d00616/P300/Hardware/Einbau-Sensorboard.jpg

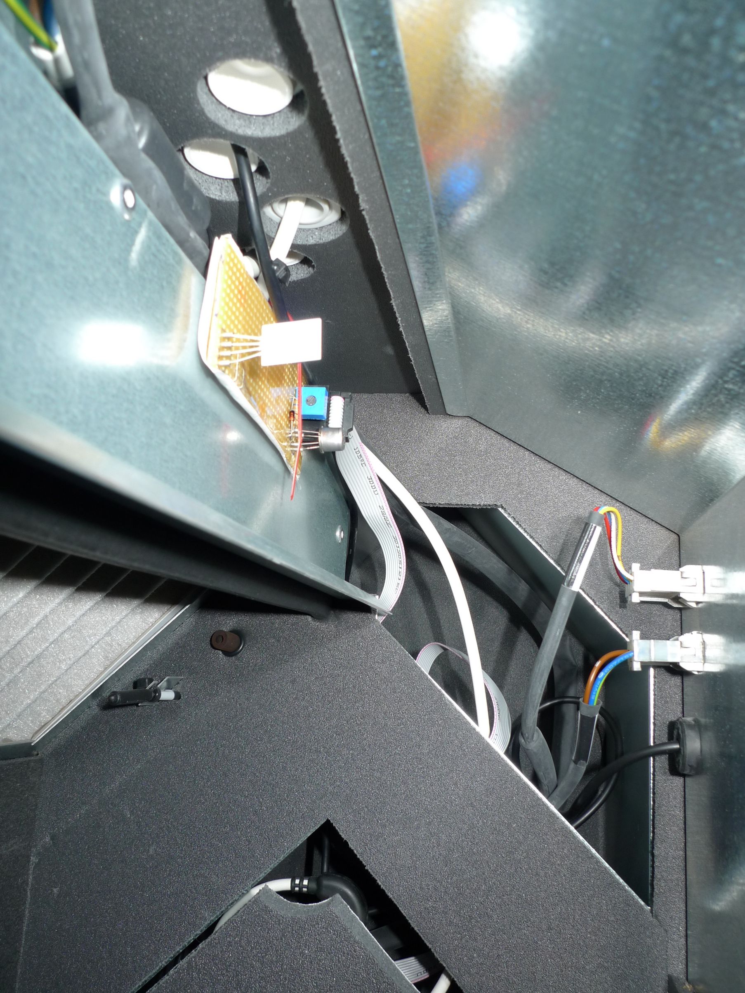
Hardware/Einbau-Sensorboard.jpg
