d00616/P300/Hardware/Einbau-und-Test-12V-Remote-Control.jpg

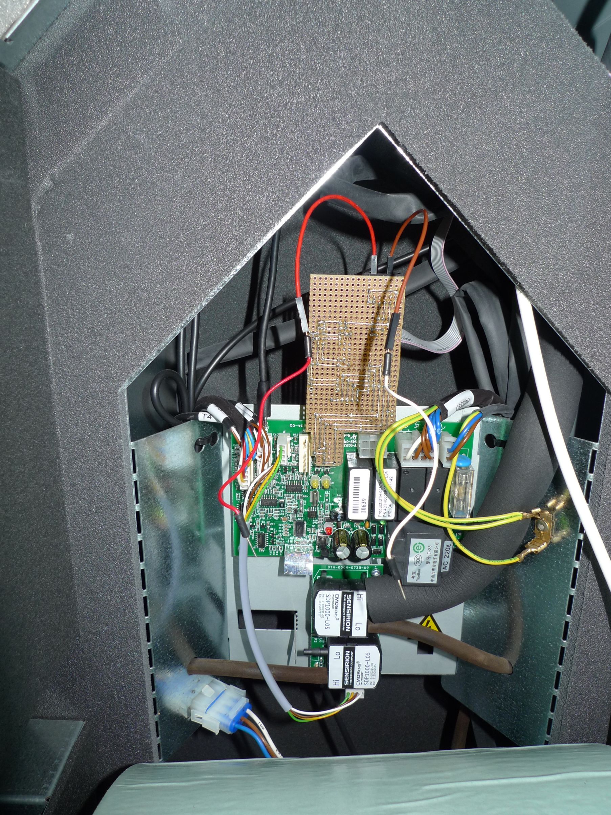
Hardware/Einbau-und-Test-12V-Remote-Control.jpg
