d00616/P300/Hardware/Einbau-Bestueckung.jpg

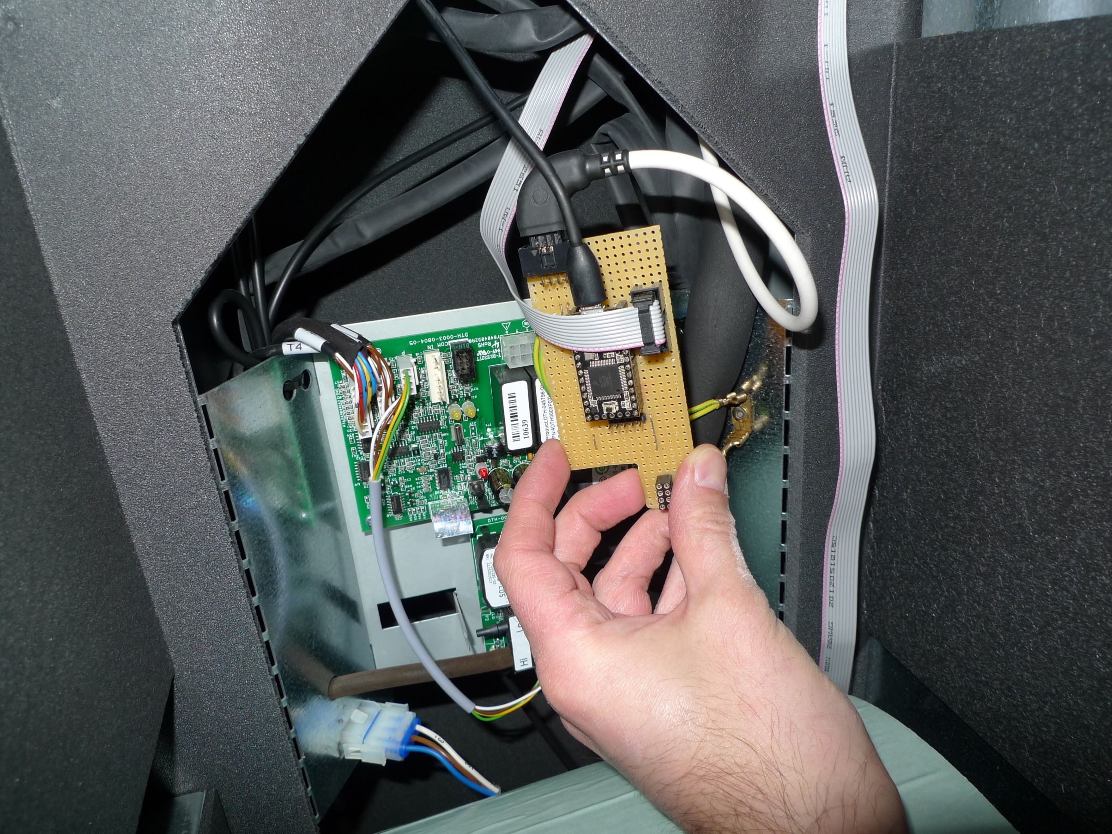
Hardware/Einbau-Bestueckung.jpg
