d00616/P300/Hardware/Einbau-USB-Kabel.jpg

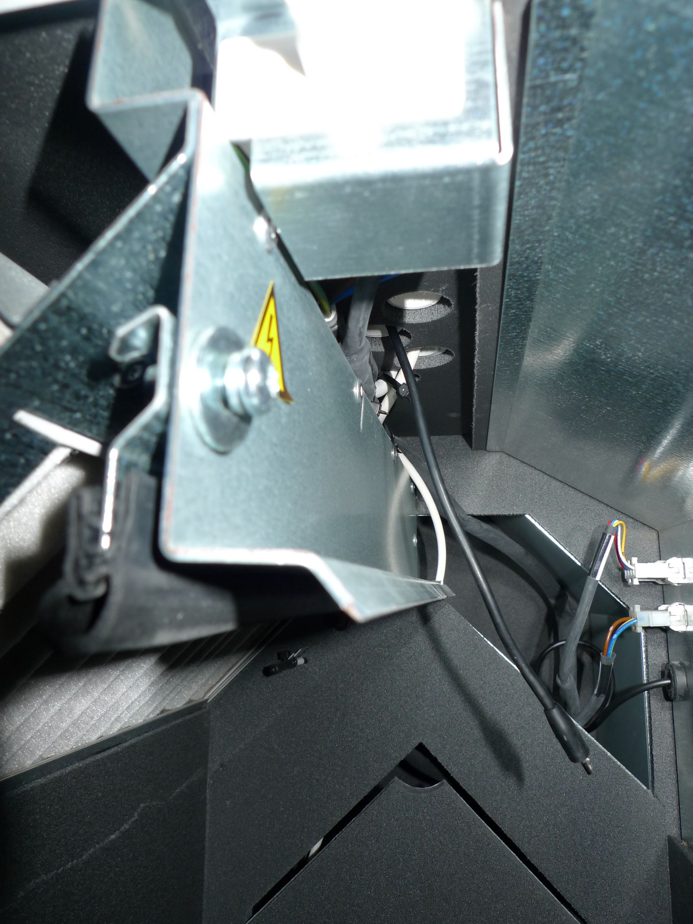
Hardware/Einbau-USB-Kabel.jpg
