d00616/P300/Hardware/Lochraster-Schema.jpg

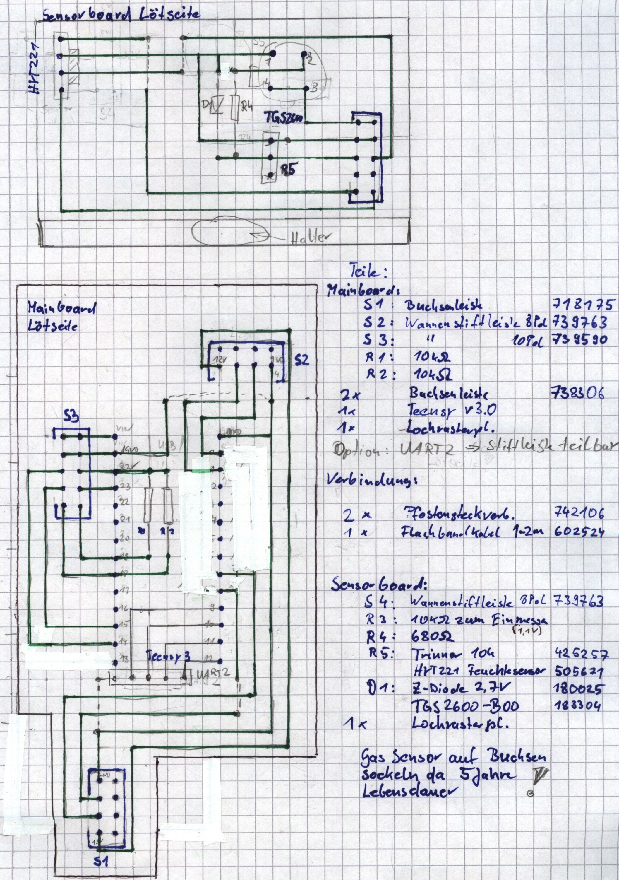
Hardware/Lochraster-Schema.jpg
