d00616/P300/Hardware/mainboard-bestueckt.jpg

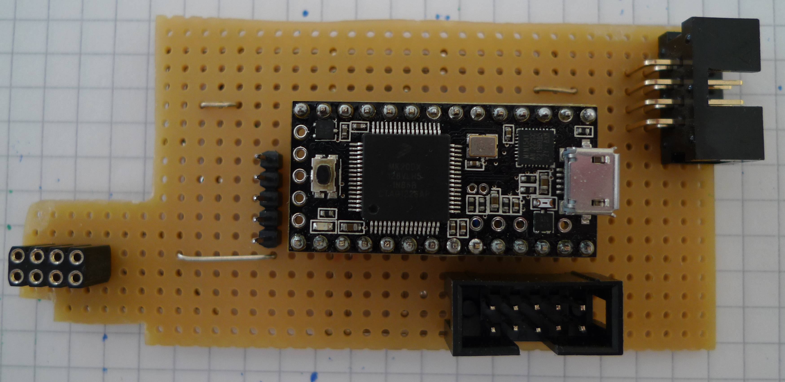
Hardware/mainboard-bestueckt.jpg
