d00616/P300/Hardware/mainboard-oben.jpg

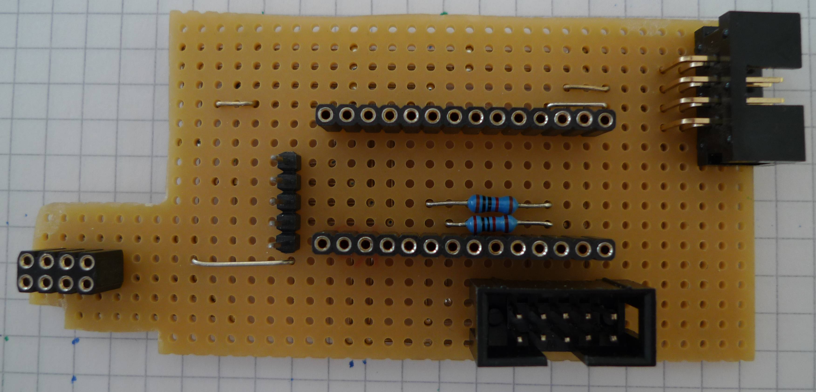
Hardware/mainboard-oben.jpg
