d00616/P300/Hardware/mainboard-unten.jpg

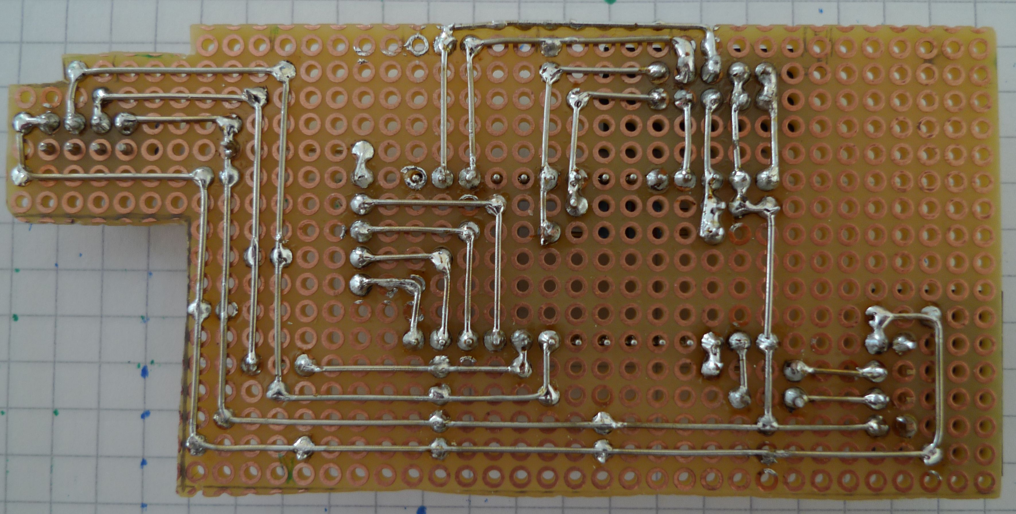
Hardware/mainboard-unten.jpg
