d00616/P300/Hardware/sensor-oben.jpg

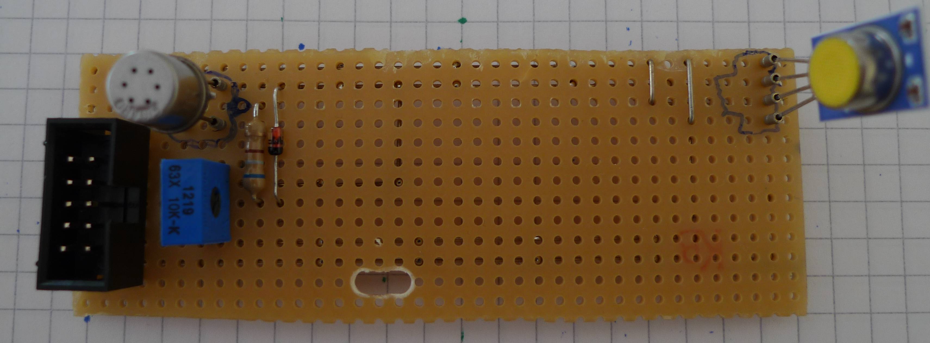
Hardware/sensor-oben.jpg
