d00616/P300/Hardware/sensor-unten.jpg

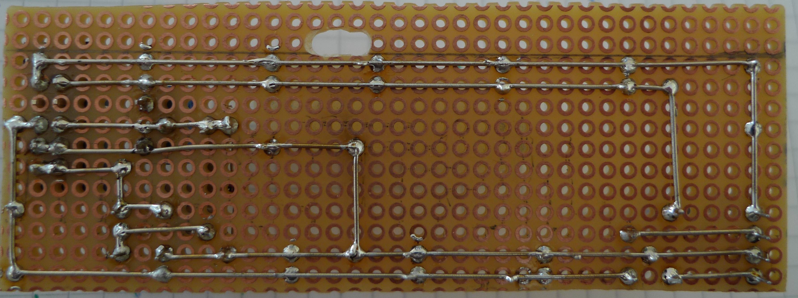
Hardware/sensor-unten.jpg
