d00616/P300/Hardware/kalibrieren-1.1V.JPG

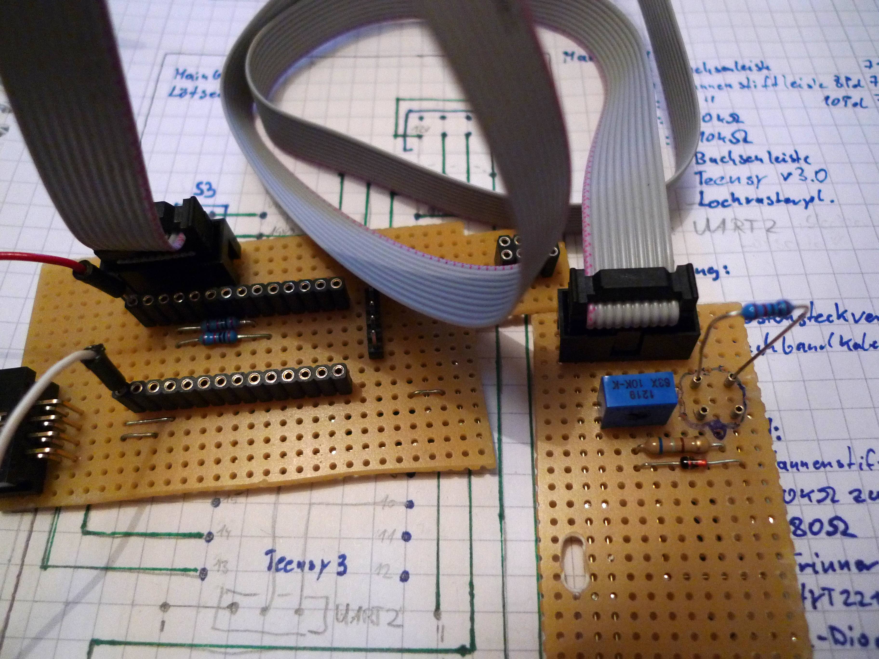
Hardware/kalibrieren-1.1V.JPG
