d00616/P300/P300/P300.ino

/*
 * P300 Controller
 *
 * Belegung UART3 = P300
 *          UART1 = Remote Control Controller
 *
 *
 *
 *
 */
#define RELEASE "2.1.1"

#include "config.h"
#include <stdarg.h>
// teensy I2C Library
#include <i2c_t3.h>
#include <EEPROM.h>
#include <IntervalTimer.h>
#include "bitlash.h"
#include "modbuscrc.h"
#include "clock.h"

#ifdef DEBUG
  bool debug;
#endif
  bool setupfinished;
#ifdef EEPROM_CRASHDEDECTION
  bool crashdedection;
#endif

ProxyObj proxy_rc;
ProxyObj proxy_intern;

ProxyObj* proxy_source;

ModbusCRC crc;

Clock clock;

// Idle Timer
IntervalTimer Timer_ms;
IntervalTimer Timer_serial;
IntervalTimer Timer_clock;

uint16_t idle_timer;
uint16_t sensor_timeout;
uint16_t p300_refresh_timeout;
uint16_t watchdog_timer;
#ifdef CALIBRATION_TIME
  uint16_t calibration_timer;
#endif
// loop() or timerCallbackSerial()
bool watchdogsource;
bool inCallbackSerial;
bool inReadWriteModbus;
bool stopModbus;
uint8_t recursion_counter;

// P300 sensor values
int8_t p300_t[4]={-100,-100,-100,-100};
uint16_t p300_s[2]={0,0};
int8_t p300_volume_flow_rate=0;

// HYT-221 sensors
#if defined(SENSOR_HYT) && SENSOR_HYT >= 1
  double hy_temp[SENSOR_HYT];
  double hy_humidity[SENSOR_HYT];
#endif

// http://playground.arduino.cc/Main/Printf
void p(char *fmt, ... ){
        char tmp[512]; // resulting string limited to 512 chars
        va_list args;
        va_start (args, fmt );
        vsnprintf(tmp, sizeof(tmp), fmt, args);
        va_end (args);
        Serial.print(tmp);
}

void setup() {
  #ifdef LED_PIN
    pinMode(LED_PIN, OUTPUT);
    digitalWrite(LED_PIN, HIGH);
    delay(200);
    digitalWrite(LED_PIN, LOW);
    delay(200);
    digitalWrite(LED_PIN, HIGH);
  #endif
  
  Serial.begin(PC_BAUD_RATE);
  p("P300 Version %s\r\n", RELEASE);
    
// Crash -> reboot to boot loader
  #ifdef EEPROM_CRASHDEDECTION
  p("Start crash dedection: ");
  if (EEPROM.read(EEPROM_CRASHDEDECTION)<255)
  {
    p("failed. Reset to bootloader.\r\n");
    Serial.flush();
    #ifdef LED_PIN
     blink(BLINK_SETUP_FAIL);
    #endif
    EEPROM.write(EEPROM_CRASHDEDECTION,255);
    reset_to_bootloader();
  }
  // Don't reboot after flashing new firmware
  if (EEPROM.read(EEPROM_NEWFIRMWARE)<255)
  {
    EEPROM.write(EEPROM_CRASHDEDECTION,0);
    crashdedection=true;
  }
    else
  {
    EEPROM.write(EEPROM_NEWFIRMWARE,0);
    crashdedection=false;
  }
  p("OK.\r\n");
  #endif

  setupfinished=false;

  #ifdef DEBUG
    // default debug state
    debug=false;
  #endif

  // Setup serial ports
  p("Initialize P300 communication: ");
  SERIAL_P300.begin(P300_BAUD_RATE);
  SERIAL_RC.begin(P300_BAUD_RATE);
  crc=ModbusCRC();

  // Reset Proxy Objects
  resetProxyObj(&proxy_rc);
  resetProxyObj(&proxy_intern);
  #ifdef DEBUG
    proxy_rc.name    ="RC ";
    proxy_intern.name="INT";
  #endif

  // Define proxy_source
  proxy_source=NULL;
  
  // Set Idle timer
  idle_timer=0;
  
  // Set Sensor timer
  sensor_timeout=0;
  
  // p300 refresh timeout
  p300_refresh_timeout=0;
  
  #ifdef CALIBRATION_TIME
    // calibration timer
    calibration_timer=0;
  #endif

  // Watchdog timer
  watchdog_timer=0;
  watchdogsource=false;
  
  // Recursion counter
  recursion_counter=0;
  inReadWriteModbus=false;
  stopModbus=false;
  
  // set this to volume flow rate 2
  p300_volume_flow_rate=2;
 
  // Initialize 1ms timer with watchdog
  Timer_ms.begin(timerCallbackMs, 2000);
  
  // Initialize serial timer
  inCallbackSerial=false;
  Timer_serial.begin(timerCallbackSerial, 10000000/P300_BAUD_RATE);
  
  // Clock timer
  clock=Clock();
  Timer_clock.begin(timerCallbackClock, 1000000);

  // Initialize I2C Bus
  p("OK.\r\nInitialize I2C: ");
  Wire.begin(I2C_MASTER, 0, I2C_PINS_18_19, I2C_PULLUP_EXT, I2C_RATE_100); // Teensy 3.0
  Wire.setDefaultTimeout(WIRE_TIMEOUT);
  p("OK\r\n");
  
  // Initialize gas sensors
  #if defined(SENSOR_GAS) && SENSOR_GAS >= 1
    for (char i=0;i<SENSOR_GAS;i++)
    {
       p("Initialize gas sensor %i ", i);
       gas_sensors[i]=new GasSensor(i, gassensor_pins[i]);
       p("OK\r\n");
    }
  #endif
  
  // initialize bitlash and set primary serial port baud
  // print startup banner and run the startup macro
  p("Start bitlash interpreter.\r\n");
  initBitlash(PC_BAUD_RATE);
  // Bitlash functions
  addBitlashFunction("flash", (bitlash_function) reset_to_bootloader);
  addBitlashFunction("p300help", (bitlash_function) cmd_p300help);
  addBitlashFunction("sensor", (bitlash_function) cmd_sensor);
  addBitlashFunction("clock", (bitlash_function) cmd_clock);
  addBitlashFunction("modbus", (bitlash_function) cmd_modbus);
  addBitlashFunction("stopmodbus", (bitlash_function) cmd_stopmodbus);
  #ifdef DEBUG
    addBitlashFunction("debug", (bitlash_function) cmd_debug);
  #endif
#if defined(SENSOR_GAS) && SENSOR_GAS >= 1
  // backup gas sensor statistics
  addBitlashFunction("backup", (bitlash_function) cmd_backup);
#endif

  #ifdef LED_PIN
    digitalWrite(LED_PIN, LOW);
  #endif
  
  setupfinished=true;
  p("Setup finished. Version: %s\r\n", RELEASE);
}

// Reset function
numvar reset_to_bootloader()
{
  #ifdef LED_PIN
   digitalWrite(LED_PIN, LOW);
  #endif
  p("Reboot.\r\n");
  Serial.flush();

  cli();
  delay(100);
  _reboot_Teensyduino_();
}

// reboot function
void reboot()
{
  #ifndef SCB_AIRCR_SYSRESETREQ_MASK
    #define SCB_AIRCR_SYSRESETREQ_MASK ((unsigned int) 0x00000004)
  #endif

  #ifdef LED_PIN
   digitalWrite(LED_PIN, LOW);
  #endif

  cli();
  delay(100);
  SCB_AIRCR = 0x05FA0000 | SCB_AIRCR_SYSRESETREQ_MASK;
  while(1);
}

// bitlash p300help
numvar cmd_p300help(void)
{
        p(
          "P300 Controller Release=\"" RELEASE "\" Build=\"" __DATE__ " " __TIME__ "\"\r\n"
          "Commands:\r\n"
          "p300help\r\n"
          "boot\tReboot Application\r\n"
          "flash\t\Reboot to loader\r\n"
         );
        #ifdef DEBUG
          p(
            "debug(0|1)\tdisable|enable debug messages\r\n"
            "debug(10)\tDump internal variables\r\n"
            #if defined(SENSOR_GAS) && SENSOR_GAS >= 1
            "debug(11)\tDump gas sensor quality map\r\n"
            #endif
          ); 
        #endif
         p("sensor(TYPE,NUM[,MULTIPLICATOR])\r\n\tRead value of sensor TYPE,NUM\r\n\tTYPE=1\tInternal temperature sensor\r\n");
        #if defined(SENSOR_HYT) && SENSOR_HYT >= 1
         p("\tTYPE=2\tExternal temperature sensor\r\n\tTYPE=3\tExternal humidity sensor\r\n");
        #endif
        #if defined(SENSOR_GAS) && SENSOR_GAS >= 1
         p("\tTYPE=4\tExternal air quality sensor absolute value\r\n\tTYPE=5\tExternal air quality sensor relative value\r\n\tTYPE=6\tExternal air quality sensor 3 minute relative delta\r\n");
        #endif
  	 p("\tTYPE=7\tS1/S2\r\n\tTYPE=8\tVolume flow rate\r\nclock(VAL)\tread clock 0=second,1=minute,2=hour,3=weekday -> 1=Mon-7=Sun\r\nmodbus(addr[,val])\tread or write word from/to P300 register\r\n\t\t!100,000 EEPROM write cycles available!\r\n\t\tRegister: https://github.com/d00616/P300/wiki/Modbus-Register\r\n");
        #ifdef CALIBRATION_TIME
	 p("stopmodbus(0|1|2)\tStop modbus communication e.g. for calibartion (2=reset P300 calibration timer)\r\n");
        #else
	 p("stopmodbus(0|1)\tStop modbus communication e.g. for calibartion\r\n");
        #endif
        #if defined(SENSOR_HYT) && SENSOR_HYT >= 1
         p("backup()\tCreate restore script for learned values\r\n");
        #endif

  return 0;
}

// bitlash sensor function
numvar cmd_sensor(void)
{
  numvar ret=-100;
  if (getarg(0)>=2)
  {
    float fret = -200;
    char n=getarg(2)-1;
    switch (getarg(1))
    {
        // Internal P300 sensor
        case 1:
	  if ( (n>=0) && (n<4)) fret=p300_t[n];
          break;
        #if defined(SENSOR_HYT) && SENSOR_HYT >= 1
        // External HYT Sensor
        case 2:
          if ( (n>=0) && (n<SENSOR_HYT)) fret=hy_temp[n];
          break;
        case 3:
          if ( (n>=0) && (n<SENSOR_HYT)) fret=hy_humidity[n];
          break;
        #endif      
        #if defined(SENSOR_GAS) && SENSOR_GAS >= 1
        // Gas sensor
        case 4:
          if ( (n>=0) && (n<SENSOR_GAS)) fret=gas_sensors[n]->getValue();
          break;
        case 5:
          if ( (n>=0) && (n<SENSOR_GAS)) fret=gas_sensors[n]->getQuality();
          break;
        case 6:
          if ( (n>=0) && (n<SENSOR_GAS)) fret=gas_sensors[n]->getQualityHistoryDelta();
          break;
        #endif      
        // Internal P300 sensor
        case 7:
	  if ( (n>=0) && (n<2)) fret=p300_s[n];
          break;
        // Volume flow rate level
        case 8:
          fret=p300_volume_flow_rate;
          break;
    }
    // multiplication
    if (getarg(0)>2)
    {
      ret=(numvar)(fret*getarg(3));
    }
      else
    {
       ret=(numvar)fret;
    }
    
  }
  return ret;
}

// bitlash sensor function
numvar cmd_clock(void)
{
  switch( getarg(1))
  {
    case 0:
        return clock.getSecond();
        break;
    case 1:
        return clock.getMinute();
        break;
    case 2:
        return clock.getHour();
        break;
    case 3:
        return clock.getWeekday();
        break;
  }
  return -1;
}

// read or write P300 registers
bool readwriteModbus(uint16_t address, uint8_t registercount, bool write)
{
  // stop modbus communication
  if (stopModbus) return false;
  
  // disable interrupts
  cli();

  // no double call
  if (inReadWriteModbus)
  {
    sei();
    #ifdef DEBUG
     if (debug) p("D readwriteModbus inReadWriteModbus ret=false\r\n");
    #endif
    return false;
  }
  inReadWriteModbus=true;
  
  // reservation of serial port if possible
  if (proxy_source==NULL) proxy_source=&proxy_intern;
  // Ser proxyObj to a known state
  resetProxyObj(&proxy_intern);
  
  // Enable interrupts
  sei();
  
  char waitforbytes = 5+(registercount*2); // read answer
  
  // check buffer size
  if (waitforbytes>SERIAL_BUFFER_SIZE) return false;
  if ( (write) && (registercount>(SERIAL_BUFFER_SIZE-MODBUS_BUFFER_WRITE_START-2)/2)) return false;
  
  bool ret = false;
    
  // Reset CRC
  crc.clearCRC();
      
  // Write Modbus Address
  addToProxyObj(&proxy_intern, 0x01, false);
  crc.add_byte(0x01);
  
  if (!write)
  {
    // Function Code: 0x03 Read Holding Registers
    addToProxyObj(&proxy_intern, 0x03, false);
    crc.add_byte(0x03);
  }
    else
  {
    // Function Code: 0x10 Preset Multiple Registers
    addToProxyObj(&proxy_intern, 0x10, false);
    crc.add_byte(0x10);  
  }
    
  // Write adress
  addWordToProxyObj(&proxy_intern, address, &crc);

  // Number of registers to read/write
  addWordToProxyObj(&proxy_intern, registercount, &crc);
    
  // Write
  if (write)
  {
    // registercount*2 bytes following
    addToProxyObj(&proxy_intern, registercount*2, false);
    crc.add_byte(registercount*2);
    
    uint8_t end = proxy_intern.buffer_wpos+registercount*2;
    if (end>SERIAL_BUFFER_SIZE-2)
    {
      inReadWriteModbus=false;
      return false; // to much for this buffer
    }
    
    for (uint8_t i=proxy_intern.buffer_wpos;i<end;i++)
    {
      crc.add_byte(proxy_intern.buffer[i]);
      proxy_intern.buffer_wpos++;      
    }
     
    waitforbytes=6+(registercount*2); // write answer
  }
    
  // CRC senden
  addWordToProxyObj(&proxy_intern, crc.getCRC(), NULL);
  
  // calculate and wait time for both transmissions
//  delay( (proxy_intern.buffer_wpos*10)/P300_BAUD_RATE + MODBUS_TIMEOUT + (waitforbytes*10)/P300_BAUD_RATE );
    
  // Wait for end of send packet 
  #ifdef DEBUG
    if (debug) p("D Wait for answer\r\n");
  #endif
  
  // wait for incomming bytes
  while
    (
      ( (proxy_intern.age<READ_TIMEOUT) && (proxy_intern.recieve_from_p300==false) ) || 
      ( ( proxy_intern.age<READ_TIMEOUT ) && (proxy_intern.buffer_wpos<waitforbytes) && (proxy_intern.recieve_from_p300==true)  )
    )
  {
    delay(MODBUS_TIMEOUT);
  }

  // Reset wpos if nothing recieved
  if (proxy_intern.recieve_from_p300==false) proxy_intern.buffer_wpos=0;
    
  #ifdef DEBUG
    if (debug) p("D Stop wait for answer. %d bytes in buffer\r\n",proxy_intern.buffer_wpos);
  #endif
    
  if (proxy_intern.buffer_wpos>0)
  {
    // Check answer
    crc.clearCRC();
    uint8_t i =0;
    for (;i<proxy_intern.buffer_wpos-2;i++) crc.add_byte(proxy_intern.buffer[i]);
    if (crc.compareCRC(proxy_intern.buffer[i++],proxy_intern.buffer[i++]))
    {
      #ifdef DEBUG
        if (debug) p("D CRC OK\r\n");
      #endif
      ret = true;
    }
       else
    {   
      #ifdef DEBUG
        if (debug) p("D CRC error\r\n");
      #endif

      // Wait for timeout for possible recursion call
      while (proxy_intern.age<READ_TIMEOUT)
      {
         delay(MODBUS_TIMEOUT);
      }
    }
  }

  // Hold buffer at sucessful read operations
  if (!((write==false) && (ret==true))) inReadWriteModbus=false;
  #ifdef DEBUG
     if (debug) p("D readwriteModbus return = %d\r\n",ret);
  #endif
  
  // Force refresh when written to address 0 for better gas sensor statistics
  if ( (write==true) && (address==0) ) p300_refresh_timeout=P300_REFRESH_TIME;
  
  return ret;
}

// read Word from modbus buffer
uint16_t readModbusWord(uint8_t address)
{
  uint8_t basis=MODBUS_BUFFER_READ_START+(address*2);
  return (proxy_intern.buffer[basis]<<8)+proxy_intern.buffer[basis+1];
}

// bitlash modbus function
numvar cmd_modbus(void)
{
  // stop modbus communication
  if (stopModbus) return -3;
  
  #ifdef CALIBRATION_TIME
    // in Calibration
    if (calibration_timer>0) return -4;
  #endif
  
  // endless loop protection
  if (recursion_counter>3) return -2;
  recursion_counter++;

  #ifdef DEBUG
    if (debug) p("D Start cmd_modbus instance %d\r\n",recursion_counter);
  #endif
  
  char numarg = getarg(0);
  bool write = false;
  bool retmodbus;
  if (numarg==2) write=true;
  numvar ret = -1;
  
  // One or two arguments
  if ( (numarg>0) && (numarg<3))
  {
    if (write)
    {
        // write data to buffer
        proxy_intern.buffer[MODBUS_BUFFER_WRITE_START] = (uint16_t)getarg(2) >> 8;
        proxy_intern.buffer[MODBUS_BUFFER_WRITE_START+1] = (uint16_t)getarg(2) & 0xff;
    }
    
    retmodbus = readwriteModbus((uint16_t)getarg(1), 1, write);
    
    if (retmodbus==true)
    {
      if (write==false)
      {
        ret = readModbusWord(0);
        inReadWriteModbus=false;
      }
    }
      else
    {
      // recursive call
      watchdog_timer=0;
      delay(READ_TIMEOUT);
      ret = cmd_modbus();
    }
  }
  
  // Wrong arguments
  recursion_counter--;
  return ret;
}

numvar cmd_stopmodbus(void)
{
  numvar ret = stopModbus;
  if (getarg(0)==1)
  {
    if (getarg(1)!=2) stopModbus=getarg(1);
     #ifdef CALIBRATION_TIME
      // force stop calibration timer until next calibration dedection
      else calibration_timer=0;
     #endif
  }
}

// bitlash debug function
#ifdef DEBUG
numvar cmd_debug(void)
{
  numvar ret=(numvar)debug;
  if (getarg(0)==1)
  {
    numvar arg = getarg(1);
    switch (arg)
    {
      case 0:
        debug=false;
        break;
      case 1:
        debug=true;
        break;
      case 10:
          p(
           "uptime=%ds\r\n"
           "proxy_source=%s\r\n"
           "proxy_rc.wpos rpos age=%d %d %d\r\n"
           "proxy_intern.wpos rpos age=%d %d %d\r\n"
           "rc.available=%d\r\n"
           "p300.available=%d\r\n"
           "idle_timer=%d\r\n"
           "sensor_timeout=%d\r\n"
           "watchdog_timer=%d\r\n"
           ,millis()/1000,
           (proxy_source==NULL)?"NULL":proxy_source->name,
           proxy_rc.buffer_wpos,proxy_rc.buffer_rpos,proxy_rc.age,
           proxy_intern.buffer_wpos,proxy_intern.buffer_rpos,proxy_intern.age,
           SERIAL_RC.available(),
           SERIAL_P300.available(),
           idle_timer,
           sensor_timeout,
           watchdog_timer
         );
        break;
      #if defined(SENSOR_GAS) && SENSOR_GAS >= 1
      case 11:
        // dump htmap
        for (char i=0;i<SENSOR_GAS;i++)
        {
          // head
          p("Sensor %d:\r\n T %%",(uint8_t)(i+1));
          for (uint8_t hum=0; hum<HT_MAP_COUNT_HUM; hum++)
          {
            p("%6d",(int)((hum*HT_MAP_DIV_HUM)+HT_MAP_MIN_HUM));
          }
          p("\r\n");
          
          // data
          for (uint8_t temp=0; temp<HT_MAP_COUNT_TEMP; temp++)
          {
            p("%3d ", (int)((temp*HT_MAP_DIV_TEMP)+HT_MAP_MIN_TEMP));
            for (uint8_t hum=0; hum<HT_MAP_COUNT_HUM; hum++)
            {
              uint16_t t = (uint16_t)gas_sensors[i]->htmap_avg[hum][temp];
              if (t<65535) p("%6d", t);
                else p(" -----");
            }
            p("\r\n");
          }
        }
        break;
        #endif
    }
  }
  return ret;
}
#endif

// backup htmap
#if defined(SENSOR_GAS) && SENSOR_GAS >= 1
numvar cmd_backup(void)
{
  // create backup
  if (getarg(0)==0)
  {
    for (char i=0;i<SENSOR_GAS;i++)
    {
      for (uint8_t hum=0; hum<HT_MAP_COUNT_HUM; hum++)
      {
        for (uint8_t temp=0; temp<HT_MAP_COUNT_TEMP; temp++)
        {
          uint16_t t = (uint16_t)gas_sensors[i]->htmap_avg[hum][temp];
          if (t<65535) p("backup(%d,%i,%i,%d)\r\n", i,hum,temp,t);
        }
      }
    }
  }
    else if (getarg(0)==4)
    {
      // Restore values
      uint8_t s=getarg(1); // sensor
      if (s>=SENSOR_GAS) return -1;
      
      uint8_t hum =getarg(2); // humidity
      if (hum>=HT_MAP_COUNT_HUM) return -2;
      
      uint8_t temp = getarg(3); // temp
      if (temp>=HT_MAP_COUNT_TEMP) return -3;
      
      gas_sensors[s]->htmap_avg[hum][temp]=getarg(4);
    }
}
#endif


#ifdef LED_PIN
void blink(char n)
{
  for (char i=0;i<30;i++)
  {
   digitalWrite(LED_PIN, HIGH);
   delay(40);
   digitalWrite(LED_PIN, LOW);
   delay(40);
  }
  delay(500);
  for (char i=0;i<n;i++)
  {
   digitalWrite(LED_PIN, HIGH);
   delay(500);
   digitalWrite(LED_PIN, LOW);
   delay(500);
  }
}
#endif

void loop()
{
   #ifdef LED_PIN
    digitalWrite(LED_PIN, HIGH);
   #endif

   // Wechselwatchdog
   if (watchdogsource)
   {
       watchdog_timer=0;
       watchdogsource=false;
   }

   runBitlash();
  
  // Read Sensors
  if (idle_timer>IDLE_TIMEOUT)
  {
   if (sensor_timeout>=SENSOR_TIMEOUT)
   {
      #ifdef DEBUG
        if (debug) p("D Start reading sensors %d\r\n",millis());
      #endif
    
      #if defined(SENSOR_GAS) && SENSOR_GAS >= 1
      // read only when p300 is not stopped
      if (p300_volume_flow_rate>0) for (char i=0;i<SENSOR_GAS;i++)
      {
        uint16_t gasval = gas_sensors[i]->loopAction((char)hy_temp[i],(char)hy_humidity[i]);
        #ifdef DEBUG
         if (debug) p("D gas sensor %d=%d\r\n",i,gasval);
        #endif
      }
      #endif

      #if defined(SENSOR_HYT) && SENSOR_HYT >= 1
      for (char num_sensor=0;num_sensor<SENSOR_HYT;num_sensor++)
      {
        readHYT(hy_addresses[num_sensor], &hy_temp[num_sensor], &hy_humidity[num_sensor]);
      }
      #endif    

      #ifdef DEBUG
        if (debug) p("D End reading sensors %d\r\n",millis());
      #endif
      sensor_timeout=0;
    }

    #ifdef CALIBRATION_TIME
      if ( (p300_refresh_timeout>=P300_REFRESH_TIME) && (inReadWriteModbus==false) && (calibration_timer==0) )
    #else
      if ( (p300_refresh_timeout>=P300_REFRESH_TIME) && (inReadWriteModbus==false) )
    #endif
    {
        #ifdef DEBUG
          if (debug) p("D Start reading p300 registers %d\r\n",millis());
        #endif
        
        #ifdef CALIBRATION_TIME  
        // Check for calibration
        if (readwriteModbus(25, 1, false))
        {
          if (readModbusWord(0)!=3)
          {
            // Skip reading modbus next time
            calibration_timer = CALIBRATION_TIME;
            inReadWriteModbus=false;
            
            #ifdef DEBUG
              if (debug) p("D Calibration in progress skip reading modbus\r\n");
            #endif
          }
            else
          #endif
          {
            // Free modbus
            inReadWriteModbus=false;

            // read registers
            // https://github.com/d00616/P300/wiki/Modbus-Register
            if (readwriteModbus(0,22,false)==true)
            {
              // Copy volume flow rate
              p300_volume_flow_rate=readModbusWord(0);
              
              // Copy temperatures
              for (uint8_t i=0;i<4;i++)
              {
                p300_t[i] = readModbusWord(i+16); // 16==T1
                #ifdef DEBUG
                  if (debug) p("D T%d=%d\r\n",i+1,p300_t[i]);
                #endif
              }
              // Copy S1/S2
              for (uint8_t i=0;i<2;i++)
              {
                  p300_s[i] = readModbusWord(i+20)*2; // 20==T1
                  #ifdef DEBUG
                    if (debug) p("D S%d=%d\r\n",i+1,p300_s[i]);
                  #endif
              }
       
              // Set time
              uint8_t weekday=readModbusWord(2);
              switch (weekday)
              {
                case 4: 
                  weekday = 3;
                  break;
                case 8:
                  weekday = 4;
                  break;
                case 16:
                  weekday = 5;
                  break;
                case 32:
                  weekday = 6;
                  break;
                case 64:
                  weekday = 7;
                  break;
              }
              #ifdef DEBUG
                if (debug) p("D setTime(%d,%d,%d)\r\n",readModbusWord(3),readModbusWord(4), weekday);
              #endif
              clock.setTime(readModbusWord(3),readModbusWord(4),weekday);
          
              // free ressource
              inReadWriteModbus=false;
            }
          }
        #ifdef CALIBRATION_TIME
        }
        #endif
        #ifdef DEBUG
          if (debug) p("D End reading p300 registers %d\r\n",millis());
        #endif
        p300_refresh_timeout=0;
    }
  }

  // Crash detection, release EEPROM Value after 30 Seconds uptime
  #ifdef EEPROM_CRASHDEDECTION
  if ( (crashdedection==true) && (millis()>CRASH_DETECTION_TIMEOUT))
  {
    if (EEPROM.read(EEPROM_CRASHDEDECTION)<255) EEPROM.write(EEPROM_CRASHDEDECTION,255);
    crashdedection=false;
  }
  #endif  
  
   #ifdef LED_PIN
    digitalWrite(LED_PIN, LOW);
   #endif

  // Sleep until next interrupt
  asm volatile("wfi\r\n"::);
}

#if defined(SENSOR_HYT) && SENSOR_HYT >= 1
void readHYT(char address, double *temp, double *humidity)
{
    // Read 4 bytes from HYT sensor
    uint8_t buffer_pos;
    uint8_t buffer[4];
    
    // Send Measurement Request
    Wire.beginTransmission(address);
    if (Wire.write(0)!=1)
    {
      #ifdef DEBUG
        if(debug) p("D Error writing to HYT sensor %x\r\n",address);
      #endif
      return;
    }
    Wire.endTransmission();
    
    // Read data
    Wire.requestFrom(address, 4);
    for (buffer_pos=0;buffer_pos<4;buffer_pos++)
    {
      if (Wire.available()) buffer[buffer_pos]=Wire.read();
        else break;
    }
    if (buffer_pos==4)
    {
      // Check for answer
      if ( (buffer[0]+buffer[1]+buffer[2]+buffer[3])>0)
      {
        // Calculate values
        *temp = 165.0/pow(2,14)*(double)(buffer[2] << 6 | (buffer[3] & 0x3F))-40;
        *humidity = 100/pow(2,14)*(double)((buffer[0]<<8 | buffer[1]) & 0X3FFF);
      }
        else
      {
        // Set dummy values
        *temp = 20;
        *humidity = 50;
      }
      #ifdef DEBUG
        if(debug) p("D Read from HYT sensor %x temp=%f humidity=%f\r\n",address,temp,humidity);
      #endif
    }
    #ifdef DEBUG
      else if(debug) p("D Error read from HYT sensor %x\r\n",address);
    #endif
}
#endif

// Initialize ProxyObj with defined values
void resetProxyObj(ProxyObj *obj)
{
  cli();

  // Initialize Buffer
  obj->buffer_rpos=0;
  obj->buffer_wpos=0;
  obj->age=0;
  obj->recieve_from_p300=false;

  sei();
  #ifdef DEBUG
    if (debug)
    {
      p("D Reset %s\r\n",obj->name);
    }
  #endif
}

// Add Data to ProxyObj
void addToProxyObj(ProxyObj *obj, uint8_t data, bool recieve_from_p300)
{
  // wrong call of addToProxyObj
  if (obj==NULL)
  {
  #ifdef DEBUG
    if (debug)
    {
      p("D NULL %c BUFFER %X (NULL)\r\n",recieve_from_p300 ?'<':'>',data);
    }
  #endif
    return;
  }
  
  // Reset ProxyObj if direction changes or timeout is reaced
  if ( (recieve_from_p300!=obj->recieve_from_p300) || (obj->age>READ_TIMEOUT))
  {
     resetProxyObj(obj);
     obj->recieve_from_p300=recieve_from_p300;     
//     if (proxy_source==obj) proxy_source=NULL;
  }

  #ifdef DEBUG
    if (debug)
    {
      p("D %s %c BUFFER %X (%d)\r\n",obj->name,obj->recieve_from_p300 ?'<':'>',data, obj->buffer_wpos);
    }
  #endif
  obj->buffer[obj->buffer_wpos]=data;
  if (obj->buffer_wpos < sizeof(obj->buffer)) obj->buffer_wpos++;
  obj->age=0;

  // Reset idle timer
  idle_timer=0;
}

void addWordToProxyObj(ProxyObj *obj, uint16_t data,ModbusCRC *crc)
{
  uint8_t h = data >> 8;
  uint8_t l = data & 0xff;
  addToProxyObj(obj, h, false);
  addToProxyObj(obj, l, false);
  
  if (crc!=NULL)
  {
    crc->add_byte(h);
    crc->add_byte(l);
  }
}


// 1ms second timer
void timerCallbackMs() {
  // Increment age of data
  if (proxy_rc.buffer_wpos>0) proxy_rc.age++;
  if (proxy_intern.buffer_wpos>0) proxy_intern.age++;
//  proxy_rc.age++;
//  proxy_intern.age++;
  idle_timer++;
  
  // Software watchdog
  watchdog_timer++;  
  // reboot into program mode
  if ((!setupfinished) && (watchdog_timer>SETUP_TIMEOUT))
  {
    #ifdef LED_PIN
    cli();
    blink(BLINK_SETUP_FAIL_TIMEOUT);
    #endif
    p("Watchdog timeout in setup routine => reboot to bootloader.\r\n");
    reset_to_bootloader();
  }
  
  // Software watchdog timeout
  if ((setupfinished) && (watchdog_timer>WATCHDOG_TIMEOUT))
  {
    #ifdef LED_PIN
    cli();
    blink(BLINK_SOFTWARE_WATCHDOG);
    #endif
    // Reset
    p("Watchdog timeout => reboot.\r\n");
    Serial.flush();
    reboot();
  }
}

// Serial Timer
void timerCallbackSerial()
{
   if (inCallbackSerial) return;
   inCallbackSerial=true;
   
   // Wechselwatchdog
   if (!watchdogsource)
   {
       watchdog_timer=0;
       watchdogsource=true;
   }

   
  /*********************************************************
   * Serial Proxy handling
   *********************************************************/

  // free proxy_source if data to old
  if ( (proxy_source!=NULL) && (proxy_source->age>READ_TIMEOUT))
  {
    #ifdef DEBUG
       if (debug) p("D proxy_source=NULL timeout=%d\r\n",proxy_source->age);
    #endif
    proxy_source=NULL;
  }
    
  // Assign proxy_source
  if (proxy_source==NULL)
  {
    // Data in buffer
    if ((proxy_rc.buffer_wpos>proxy_rc.buffer_rpos) && (proxy_rc.recieve_from_p300==false))
    {
       proxy_source=&proxy_rc;
    }
    // Data in internal buffer
    if ((proxy_intern.buffer_wpos>proxy_intern.buffer_rpos) && (proxy_intern.recieve_from_p300==false))
    {
       proxy_source=&proxy_intern;
    }
   
   // Flush old data
   if (proxy_source!=NULL)
   {
     SERIAL_P300.flush(); // send outstanding data
     SERIAL_P300.clear(); // clear buffer
     #ifdef DEBUG
         if (debug) p("D proxy_source=%s\r\n",proxy_source->name);
     #endif
     proxy_source->age=0;
   }
  }

  if (proxy_source!=NULL)
  {
   // Read data from P300
   while (SERIAL_P300.available())
   {
     addToProxyObj(proxy_source, SERIAL_P300.read(), true);
   }
   
   // Send data to P300
   if ( (proxy_source->buffer_wpos>proxy_source->buffer_rpos) && (proxy_source->recieve_from_p300==false))
   {
    char c = proxy_source->buffer[proxy_source->buffer_rpos];
    SERIAL_P300.write(c);
    #ifdef DEBUG
      if (debug) p("D %s > P300 %X (%d)\r\n",proxy_source->name,c,proxy_source->buffer_rpos);
    #endif
    proxy_source->buffer_rpos++;
    proxy_source->age=0;
   }
  }
  
  // Read serial Ports
  while (SERIAL_RC.available())
  {
    addToProxyObj(&proxy_rc, SERIAL_RC.read(), false);
  }
  
  // Write to serial Ports
  if ( (proxy_rc.buffer_wpos>proxy_rc.buffer_rpos) && (proxy_rc.recieve_from_p300))
  {
     char c = proxy_rc.buffer[proxy_rc.buffer_rpos];
     SERIAL_RC.write(c);
     #ifdef DEBUG
       if (debug) p("D BUFFER > RC  %X (%d)\r\n", c, proxy_rc.buffer_rpos);
     #endif
     proxy_rc.buffer_rpos++;
     proxy_rc.age=0;
  }
  
  inCallbackSerial=false;
}

void timerCallbackClock()
{
  if (sensor_timeout<=SENSOR_TIMEOUT) sensor_timeout++;
  if (p300_refresh_timeout<=P300_REFRESH_TIME) p300_refresh_timeout++;
  #ifdef CALIBRATION_TIME
    if (calibration_timer>0) calibration_timer--;
  #endif

  clock.secondAction();
}
