d00616/P300/P300/config.h

#include <inttypes.h>
#include "modbuscrc.h"
#include "gasSensor.h"

// Debugging
#define DEBUG  1
#define LED_PIN 13

#define P300_BAUD_RATE 4800
#define PC_BAUD_RATE 115200

// in mS 1000/4800 Baud/10 * 3,5
#define MODBUS_TIMEOUT  7
#define READ_TIMEOUT 20

// time to stop modbus communication when calibartion is running (s)
// when defined modbus communication is stopped at dedected calibration
#define CALIBRATION_TIME 900

// time (ms) of inactivity before reading sensors
#define IDLE_TIMEOUT 100

// minimum time (s) between sensor readings (16 bit!)
#define SENSOR_TIMEOUT 3

// refresh time (s) for p300 data (59 seconds to learn seconds from P300 clock)
#define P300_REFRESH_TIME 59

// number of milliseconds for setup routine
#define SETUP_TIMEOUT 15000

// timeout for software watchdog
#define WATCHDOG_TIMEOUT 10000

// timeout for crash detection
// not working since bitlash integration
//#define CRASH_DETECTION_TIMEOUT 10000

// define I2C address when HYT-221 is installed
#define SENSOR_HYT 1
#ifdef SENSOR_HYT
  static char hy_addresses[SENSOR_HYT]={0x28};
#endif

// I2C Timeout in ms
#define WIRE_TIMEOUT 500

// define analog pins for GAS Sensors
// Any gas sensor must be installed near HYT sensor with same index number!
#define SENSOR_GAS 1
#ifdef SENSOR_GAS
  static int gassensor_pins[SENSOR_GAS]={14};
  GasSensor* gas_sensors[SENSOR_GAS];
#endif

// Blink codes
#define BLINK_SETUP_FAIL 2
#define BLINK_SETUP_FAIL_TIMEOUT 3
#define BLINK_SOFTWARE_WATCHDOG 4

// Commands
#define COMMAND_DELIMITER " "

// Define classes for serial communication
#define SERIAL_P300 Serial3  
#define SERIAL_RC   Serial1

#define SERIAL_BUFFER_SIZE  64

// EEPROM-MAP
//#define EEPROM_NEWFIRMWARE 2046
//#define EEPROM_CRASHDEDECTION 2047

// Modbus buffer address
#define MODBUS_BUFFER_READ_START  3
#define MODBUS_BUFFER_WRITE_START 7

// Data
struct ProxyObj
{
   uint8_t  buffer_rpos;
   uint8_t  buffer_wpos;
   char     buffer[SERIAL_BUFFER_SIZE];
   uint8_t  age;
   bool     recieve_from_p300;
   bool     transmission;
   #ifdef DEBUG
   char*  name;
   #endif
};


// Error Codes
enum errorcodes
{
  ERR_PARAMETER_VALUE  
};
