d00616/P300/(commit log)

2013-04-25 Verbesserung I2C-Code
2013-04-28 Software Watchdog I2C Fehlertolleranz
2013-05-01 Watchdog + Crash detection
    [P300.ino, config.h]
2013-05-07 Bugfix HYT Sensor lesen
    [P300.ino, config.h]
2013-07-04 Bugfix I2C (ufo dd)
    [P300.ino]
2013-08-27 Gas Sensor Quality
2013-09-22 BUgfix schreiben, manchmal watchog-reboot
    [P300.ino]
2013-09-30 Funktion zum modbus lesen und schreiben
2013-10-03 Bugfix getarg(1) -> address...
    [P300.ino, config.h]
2013-10-12 Bugfix modbus read word high byte
    [P300.ino]
2013-11-02 Calibration dedection, Typo, 3 Minute gas quality statistic
2013-11-02 Bugfix calibration dedection (modbus register), README
    [P300.ino, config.h]
2013-11-03 Stop gas sensor when volume flow is stopped
2013-11-04 Optimzation gas sensor handling/autostop
2013-11-10 SENSOR_GAS_PREHEAT_TIME 15min
2016-07-24 Fix I2C/HYT timing, robustness
    [P300.ino, config.h]
